Semea-Tec/shitakiometer/3d model/Case atualizada.stl

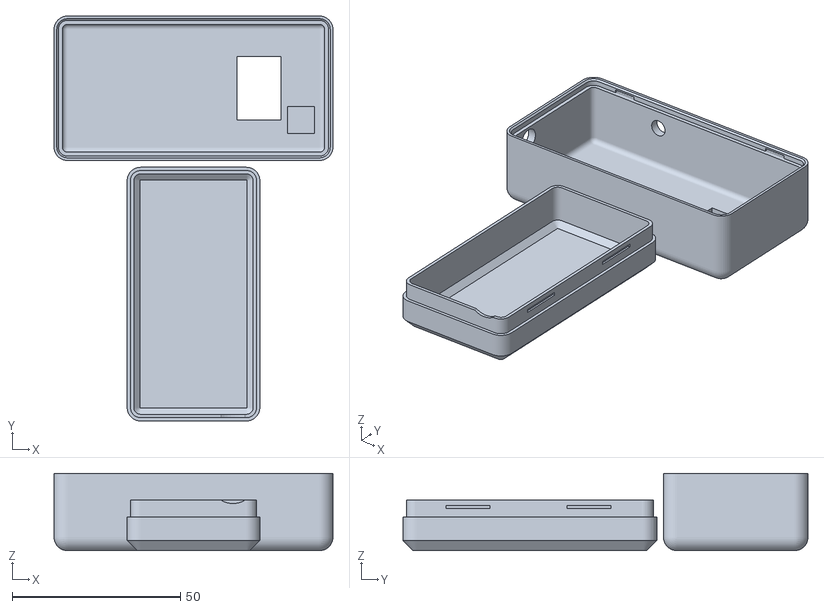
[picture p1: CAD file, 2026-05-12]
3d model/Case atualizada.stl
83.0 x 120.5 x 23.0
