Semea-Tec/shitakiometer/3d model/HeltecV3_completa.stl

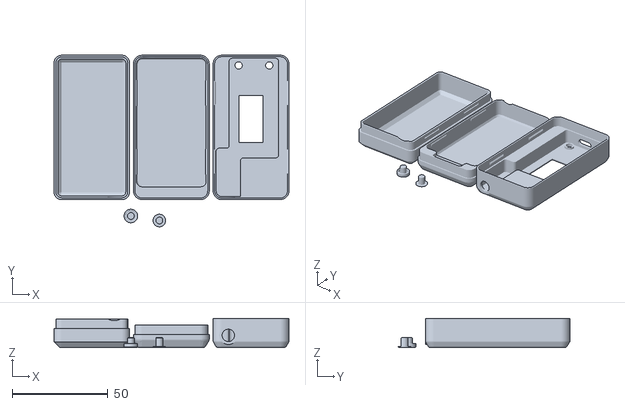
[picture p2: CAD file, 2026-05-12]
3d model/HeltecV3_completa.stl
122.8 x 89.7 x 15.2
