Semea-Tec/shitakiometer/Lora/Receiver/Receiver.ino

#include <RadioLib.h>
#include <SPI.h>
#include <Wire.h>
#include <Adafruit_GFX.h>
#include <Adafruit_SSD1306.h>

// Pins for Heltec LoRa V3 (ESP32-S3)
#define SCK_LORA 9
#define MISO_LORA 11
#define MOSI_LORA 10
#define SS_LORA 8
#define RST_LORA 12
#define BUSY_LORA 13
#define DIO1_LORA 14

#define OLED_SDA 17
#define OLED_SCL 18
#define OLED_RST 21
#define VEXT_PIN 36 // GPIO 36 controls Vext on V3
#define LED_PIN 35  // GPIO 35 is the white LED

#define SCREEN_WIDTH 128
#define SCREEN_HEIGHT 64
#define BAND 915.0 // MHz

Adafruit_SSD1306 display(SCREEN_WIDTH, SCREEN_HEIGHT, &Wire, OLED_RST);
SX1262 radio = new Module(SS_LORA, DIO1_LORA, RST_LORA, BUSY_LORA);

void setup()
{
    Serial.begin(115200);

    // Turn on Vext power (V3 uses GPIO 36)
    pinMode(VEXT_PIN, OUTPUT);
    digitalWrite(VEXT_PIN, LOW);
    delay(100);

    // Turn on built-in LED to show it's alive
    pinMode(LED_PIN, OUTPUT);
    digitalWrite(LED_PIN, HIGH);

    // Manual OLED Reset
    pinMode(OLED_RST, OUTPUT);
    digitalWrite(OLED_RST, LOW);
    delay(20);
    digitalWrite(OLED_RST, HIGH);

    // Initialize OLED
    Wire.begin(OLED_SDA, OLED_SCL);
    if (!display.begin(SSD1306_SWITCHCAPVCC, 0x3C))
    {
        for (;;)
            ;
    }

    display.clearDisplay();
    display.ssd1306_command(SSD1306_SETCONTRAST);
    display.ssd1306_command(0xFF); // Max brightness
    display.dim(false);
    display.setTextColor(WHITE);
    display.setCursor(0, 0);
    display.println("RECEIVER V3 READY");
    display.display();

    // Initialize LoRa
    Serial.print(F("[LoRa] Initializing ... "));
    int state = radio.begin(BAND);
    if (state == RADIOLIB_ERR_NONE)
    {
        Serial.println(F("success!"));
    }
    else
    {
        while (true)
            ;
    }
}

void loop()
{
    String str;
    int state = radio.receive(str);

    if (state == RADIOLIB_ERR_NONE)
    {
        Serial.println(F("[LoRa] Data received!"));
        Serial.print(F("[LoRa] Data:\t\t"));
        Serial.println(str);

        display.clearDisplay();
        display.setTextSize(1);
        display.setCursor(0, 0);
        display.println("RECEIVER V3");

        display.setCursor(0, 15);
        display.println("Value Received:");

        // setTextSize(1) para caber a string inteira numa linha sem
        // quebrar (em size(2) strings longas quebram e sobrepoem o RSSI)
        display.setCursor(0, 30);
        display.println(str);

        display.setCursor(0, 50);
        display.print("RSSI: ");
        display.print(radio.getRSSI());
        display.print(" dBm");
        display.display();
    }
}
