Semea-Tec/shitakiometer/(commit log)

2026-02-21 Teste do sensor de Temperatura
2026-03-04 CO2 sensor tested
2026-03-04 CO2 sensor MH-Z19C
2026-03-12 feat: temperature sensor system implementation
2026-03-12 docs: temperature sensor system
2026-05-12 feat: add 3d model case
    [Case atualizada.stl]
2026-05-12 fix: add complete model
    [HeltecV3_completa.stl]
2026-05-17 Sender with sensor reading
2026-06-25 Split sensor input device into XIAO ESP32-C5 + Heltec LoRa concentrator
    The new sensor input board (Seeed XIAO ESP32-C5) has far fewer GPIOs and
    no onboard LoRa/OLED, so it can no longer host sensors + LoRa transmit
    together. Split the architecture into sensor.ino (XIAO, reads DHT22/MH-Z19C,
    sends via ESP-NOW broadcast) and concentradorHeltec.ino (Heltec V3, receives
    ESP-NOW and forwards via LoRa with the same payload format, no receiver
    changes needed). Documented pin mapping and rationale in Docs/CODEBASE_MEMORY.md
    for future replication; senderWithSensors.ino kept as legacy standalone reference.
    [concentradorHeltec.ino, sensor.ino]
2026-06-25 Read MH-Z19C CO2 via PWM instead of UART
    Field MH-Z19C modules only have VCC, GND and the yellow PWM wire wired up
    (UART wires were cut to save space in the enclosure), so the UART read
    command never worked on real hardware. Switch CO2 reading to pulseIn()-based
    PWM duty-cycle measurement (Winsen formula) in both sensor.ino (XIAO) and
    the legacy senderWithSensors.ino (Heltec standalone). Documented the real
    wiring and formula in Docs/CODEBASE_MEMORY.md and flagged the mismatch in
    the Tests/Sensors/MH-Z19C lab test README.
2026-06-25 Document XIAO ESP32-C5 VBUS caveat for MH-Z19C power
    The XIAO ESP32-C5 has no pin literally labeled "5V" - the 5V rail is
    VBUS, a USB passthrough rather than a regulated output, so it only
    carries voltage while USB is connected. Note this in CODEBASE_MEMORY.md
    since it matters for the upcoming solar/battery deployment (VBUS will be
    unpowered without USB, requiring a boost converter for the MH-Z19C) and
    because a constant-LOW/timeout PWM reading is the symptom of the sensor
    being underpowered.
2026-06-25 Fix OLED text overlap in LoRa Receiver test sketch
    The received payload string at setTextSize(2) wrapped onto a second
    line on the 128x64 OLED, overlapping the RSSI line below it. Print the
    value at setTextSize(1) instead so it always fits on one line.
    [Receiver.ino]
2026-06-25 Externalize WiFi credentials and add OLED screen rotation to receiver
    Move ssid/password out of source into wifi_credentials.h (gitignored,
    .example template committed) so each person configures their own
    network locally instead of a real password living in git history.
    Also rework the OLED on receiver_webServer.ino to alternate every 3s
    between a data screen (temp/humidity/CO2) and an IP screen (for
    connecting the mobile app), dropping RSSI from the display - the small
    128x64 screen couldn't show both data and the IP without clutter.
    [receiver_mqtt.ino, receiver_webServer.ino]
2026-09-23 Add GY-BMEP280 (BME280/BMP280) PlatformIO test for Pico 2 W
    Builds and uploads with `pio run -t upload`; auto-detects BME280 vs
    BMP280 via chip ID and prints humidity only when available. Verified
    compiling and running on real Pico 2 W hardware over USB.
2026-09-23 Document hardware validation of two GY-BMEP280 sensors on Pico 2 W
    Both modules confirmed working on real hardware; readings cross-checked
    against the SBSJ airport METAR. Also documents the frozen-reading gotcha
    found while hot-swapping sensors without a USB power-cycle.
